emily-pearson/Virtual-Moon-Project/piping_setup.jpg

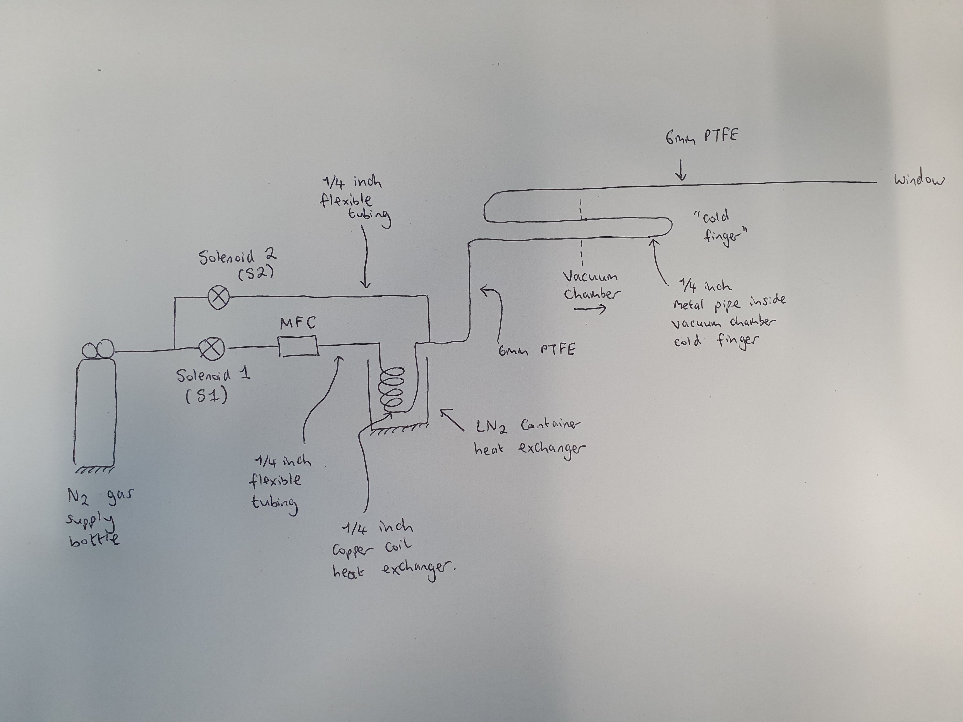
piping_setup.jpg
