emily-pearson/Virtual-Moon-Project/wiring_diagram.png

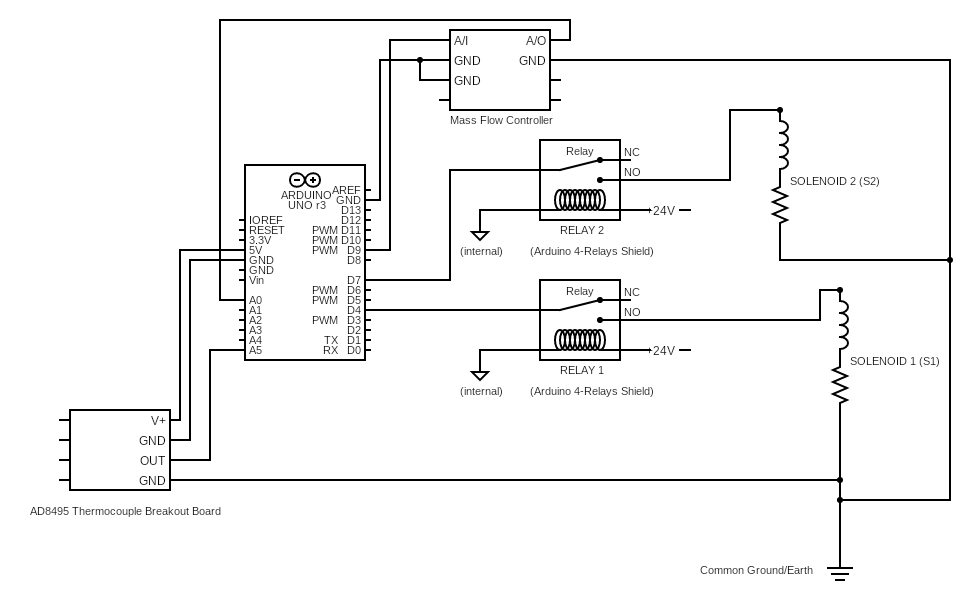
wiring_diagram.png
