emily-pearson/Virtual-Moon-Project/TEST_11.xlsx

Minutes | T1 temp | T2 temp
0 | 23.1 | 24.5
2 | 23 | 24.5
4 | 22.9 | 24.4
6 | 21.9 | 23.6
8 | 19.8 | 21.9
10 | 15.6 | 18.6
12 | 8.7 | 13.7
14 | 3.6 | 9.6
16 | -3.1 | 4.3
18 | -9.8 | -1.2
21 | -17.7 | -8.4
22 | -20.2 | -10.8
24 | -23.6 | -14.5
26 | -26.3 | -17.7
28 | -28.2 | -20.2
30 | -29.5 | -22.3
32 | -30.5 | -24
34 | -31.2 | -25.3
36 | -31.7 | -26.4
38 | -32.3 | -27.2
40 | -34.4 | -29.1
42 | -38.5 | -32.3
44 | -43.5 | -36.2
46 | -49.2 | -40.7
48 | -54.2 | -45.1
50 | -59.4 | -49.7
52 | -63.7 | -53.7
54 | -68.2 | -58.1
56 | -72.4 | -62.3
58 | -76.4 | -66.4
60 | -80.2 | -70.3
62 | -83.7 | -74.1
64 | -85.8 | -76.8
66 | -88.7 | -80.2
68 | -91.3 | -83
70 | -94.1 | -85.8
72 | -96.3 | -88.1
74 | -98.9 | -90.9
76 | -100 | -92.6
78 | -99.9 | -93.5
80 | -99.3 | -93.6
82 | -98.1 | -93.4
84 | -97.1 | -92.9
86 | -95.8 | -92
88 | -94.3 | -91
90 | -94.6 | -90.9
92 | -96.7 | -92.1
94 | -100.3 | -94.5
96 | -104.4 | -97.3
98 | -108 | -100.3
100 | -111.4 | -103.4
102 | -114.4 | -106.2
104 | -117.3 | -109.2
106 | -119.9 | -111.8
108 | -122.2 | -114.2
110 | -123.9 | -116.4
112 | -125.6 | -118.3
114 | -127.5 | -120.3
116 | -128.8 | -121.9
118 | -129.9 | -123.3
120 | -130.8 | -124.5
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
