emily-pearson/Virtual-Moon-Project/(commit log)

2025-07-01 Add first draft of Arduino MFC code
2025-07-01 Update control_mfc.m
    Update matlab code to send flow rate value to Arduino
2025-07-02 Sample code for reading and sending over serial
2025-07-02 Sample MATLAB code to go with the ADC_test.ino code
2025-07-02 Update MassFlowControl.ino
    Added function to read flow rate data, added flags to prevent arduino from sending readouts before a flow rate confirmation message has been sent
2025-07-02 Update MassFlowControl.ino
    This code currently works to switch on S1 when flow rate has been set. Only switches S1 off when code is run again from the start
2025-07-03 Update MassFlowControl.ino
    Replaced the 100ms delay after printing to serial with a millis() option instead to avoid code blocking
2025-07-03 Update control_mfc.m
    Minor adjustment to work with updated arduino code
2025-07-04 Update control_mfc.m
    Added structure to store and extract temperature data from serial
2025-07-04 Update MassFlowControl.ino
    Added code to read temperature and send both temp and flow rate over serial in a comma separated string
2025-07-04 Add readSerialData MATLAB function
    This is current with current MATLAB and Arduino versions
2025-07-07 Update MassFlowControl.ino
    Replaced delay(2000) after terminate command received with a millis() construction to avoid code blocking
2025-07-07 Update control_mfc.m
    Added function to plot received serial data. Tidied up variable names for consistent case convention
2025-07-09 Updated m and arduino codes
    Added code to store received data in an excel spreadsheet. Minor adjustments to Arduino code
2025-07-22 Added test code to hold temperature low, removed some global variables
    Added code in arduino (currently untested) to hold the temperature in a 10C range using solenoid control. Included moving average temperature to Removed some unnecessary global variables and replaced with static local variables
2025-08-01 Second version of MassFlowControl code that allows for optional temperature holding regulation
2025-08-08 Added raw data excel files
    [TEST_1.xlsx, TEST_10.xlsx, TEST_11.xlsx, TEST_2a.xlsx, TEST_2b.xlsx, TEST_3.xlsx, TEST_4.xlsx, TEST_5.xlsx]
